Floo/hsArduino/eagle/hsArduino-BOM.xlsx

Sheet: Tabelle1
Anzahl | Part | Value | Package | Sonstiges | Conrad-Best.-Nr. | Conrad-Preis | Reichelt-Best.Nr. | Reichelt-Preis | Segor-Best.-Nr. | Segor-Preis | Mouser-Best.-Nr. | Mouser-Preis | Preis pro Einheit
2 | C8, C9 | 18p | 0805 |  |  |  | NPO-G0805 18P | 0.05 € |  |  |  |  | 0.10 €
2 | C11, C12 | 22p | 0805 |  |  |  | NPO-G0805 22P | 0.05 € |  |  |  |  | 0.10 €
1 | C15 | 1n | 0805 |  |  |  | X7R-G0805 1N | 0.05 € |  |  |  |  | 0.05 €
1 | C16 | 4n7 | 0805 |  |  |  | X7R-G0805 4,7N | 0.05 € |  |  |  |  | 0.05 €
2 | C17, C19 | 6n8 | 0805 |  |  |  | X7R-G0805 6,8N | 0.05 € |  |  |  |  | 0.10 €
2 | C18, C112 | 10n | 0805 |  |  |  | X7R-G0805 10N | 0.05 € |  |  |  |  | 0.10 €
1 | C20 | 22n | 0805 |  |  |  | X7R-G0805 22N | 0.05 € |  |  |  |  | 0.05 €
24 | C7, C12, C14, C21, C22, C23, C24, C100, C101, C102, C103, C104, C105, C106, C107, C108, C109, C110, C111, C114, C115, C116, C117, C118 | 100n | 0805 |  |  |  | X7R-G0805 100N | 0.05 € |  |  |  |  | 1.20 €
1 | C13 | 1µ | 0805 |  |  |  | X7R-G0805 1,0/25 | 0.05 € |  |  |  |  | 0.05 €
1 | C113 | 4µ7 | 0805 |  |  |  | X7R-G0805 4,7/25 | 0.05 € |  |  |  |  | 0.05 €
4 | C2, C4, C5, C6 | 10µ | RM2/5 |  |  |  | RAD 10/35 | 0.04 € |  |  |  |  | 0.16 €
 | C3 | 47µ | RM2/5 |  |  |  | RAD 47/16 | 0.04 € |  |  |  |  | 0.00 €
 | C1 | 100µ | RM2,5/7 |  |  |  | RAD 100/25 | 0.04 € |  |  |  |  | 0.00 €
1 | R18 | 10 | 0805 |  |  |  |  | 0.08 € |  |  |  |  | 0.08 €
2 | R6, R7 | 22 | 0805 |  |  |  |  | 0.08 € |  |  |  |  | 0.16 €
2 | R17, R19 | 50 | 0805 |  |  |  |  | 0.08 € |  |  |  |  | 0.16 €
2 | R28, R31 | 75 | 0805 |  |  |  |  | 0.08 € |  |  |  |  | 0.16 €
2 | R15, R16 | 82 | 0805 |  |  |  |  | 0.08 € |  |  |  |  | 0.16 €
2 | R29, R30 | 150 | 0805 |  |  |  |  | 0.08 € |  |  |  |  | 0.16 €
7 | R13, R14, R25, R26, R27, R32, R33 | 220 | 0805 |  |  |  |  | 0.08 € |  |  |  |  | 0.56 €
9 | R3, R4, R11, R12, R20, R21, R23, R24, R35 | 10k | 0805 |  |  |  |  | 0.08 € |  |  |  |  | 0.72 €
1 | R9 | 12.4k 1% | 0805 |  |  |  |  | 0.08 € |  |  |  |  | 0.08 €
3 | R22, R34, R36 | 15k | 0805 |  |  |  |  | 0.08 € |  |  |  |  | 0.24 €
2 | R1, R10 | 1M | 0805 |  |  |  |  | 0.08 € |  |  |  |  | 0.16 €
1 | R2 | 4816 10k | BOURNS RESISTOR NETWORK |  |  |  |  |  |  |  | 652-4816P-1LF-10K | 0.85 € | 0.85 €
3 | R5, R8, R37 | CG0603-05 | 0603 | Varistor |  |  |  |  |  |  | 652-CG0603MLU-05E | 0.26 € | 0.78 €
1 | L1 | MH2029 | Inductor |  |  |  |  |  |  |  | 652-MH2029-100Y | 0.09 € | 0.09 €
1 | L2 | 1A 120R@100MHz 0.14R | Inductor |  |  |  |  |  |  |  | 652-MH2029-121Y | 0.09 € | 0.09 € | Woher??
1 | IC6 | MAX3232CSE | NarrowSO16 |  |  |  | MAX 3232 CSE | 1.10 € |  |  |  |  | 1.10 €
2 | Q1, Q2 | IRLML6401 | MICRO3 |  |  |  | IRLML6401 | 0.15 € |  |  |  |  | 0.30 €
1 | T2 | H1102NL |  |  |  |  |  |  |  |  | 673-H1102FNL | 4.33 € | 4.33 €
1 | IC2 | TS1117CW-3.3 | SOT223 |  |  |  | TS 1117 BCW33 | 0.30 € |  |  |  |  | 0.30 €
1 | IC1 | R-78B5.0-1.5 |  |  |  |  |  |  |  |  | 919-R-78B5.0-1.0 | 6.96 € | 6.96 € | 1 A??
1 | Q3 | 25MHz HC49 | LowProfile |  |  |  | 25,0000-HC49U-S | 0.17 € |  |  |  |  | 0.17 €
1 | Q4 | 16MHz HC49 | LowProfile |  |  |  | 16,0000-HC49U-S | 0.14 € |  |  |  |  | 0.14 €
2 | T1, T3 | BC859(BC807-40) |  |  |  |  | BC 859C SMD | 0.04 € |  |  |  |  | 0.08 €
2 | D1, D2 | BAS40 | SOT-23 |  |  |  | BAS 40 SMD | 0.07 € |  |  |  |  | 0.14 €
1 | D4 | BAS40-04 | SOT-23 |  |  |  | BAS 40-04 SMD | 0.05 € |  |  |  |  | 0.05 €
1 | U1 | W5500 |  |  |  |  |  |  |  |  | 950-W5500 | 2.69 € | 2.69 €
1 | U2 | ATMEGA32U4-AU |  |  |  |  |  |  |  |  | 556-ATMEGA32U4-AU | 5.13 € | 5.13 €
1 | IC3 | LMV321M5 | SOT23-5 |  |  |  |  |  |  |  | 926-LMV321M5/NOPB | 0.70 € | 0.70 €
2 | IC4, IC5 | 74LVC1G14DBV | SOT23-5 |  |  |  |  |  |  |  | 595-SN74LVC1G14DBVR | 0.41 € | 0.82 €
1 | SV1 | Wanne 6pol |  |  |  |  | WSL6G | 0.16 € |  |  |  |  | 0.16 €
1 | SV4 | Wanne 10pol |  |  |  |  | WSL10G | 0.08 € |  |  |  |  | 0.08 €
1 |  | Phoenix2pol |  |  |  | 0.56 € |  |  |  |  |  |  | 0.56 €
1 |  | Phoenix3pol |  |  |  | 0.85 € |  |  |  |  |  |  | 0.85 €
1 |  | Phoenix12pol |  |  |  | 3.37 € |  |  |  |  |  |  | 3.37 €
1 |  | Phoenix8pol |  |  |  | 2.24 € |  |  |  |  |  |  | 2.24 €
 |  |  |  |  |  |  |  |  |  |  |  |  | 36.63 €

Sheet: E6_main
Part | Value | Device | Package | Description | MF MPN OC_FARNELL OC_NEWARK
C1 | 100µ | CPOL-EUE2.5-7 | E2,5-7 | POLARIZED CAPACITOR, European | symbol
C2 | 10µ | CPOL-EUE2-5 | E2-5 | POLARIZED CAPACITOR, European | symbol
C3 | 47µ | CPOL-EUE2-5 | E2-5 | POLARIZED CAPACITOR, European | symbol
C4 | 10µ | CPOL-EUE2-5 | E2-5 | POLARIZED CAPACITOR, European | symbol
C5 | 10µ | CPOL-EUE2-5 | E2-5 | POLARIZED CAPACITOR, European | symbol
C6 | 10µ | CPOL-EUE2-5 | E2-5 | POLARIZED CAPACITOR, European | symbol
C7 | 100n | C-EUC0805K | C0805K | CAPACITOR, European symbol
C8 | 18p | C-EUC0805K | C0805K | CAPACITOR, European symbol
C9 | 18p | C-EUC0805K | C0805K | CAPACITOR, European symbol
C10 | 22p | C-EUC0805K | C0805K | CAPACITOR, European symbol
C11 | 22p | C-EUC0805K | C0805K | CAPACITOR, European symbol
C12 | 100n | C-EUC0805K | C0805K | CAPACITOR, European symbol
C13 | 1µ | C-EUC0805K | C0805K | CAPACITOR, European symbol
C14 | 100n | C-EUC0805K | C0805K | CAPACITOR, European symbol
C15 | 1n | C-EUC0805K | C0805K | CAPACITOR, European symbol
C16 | 4n7 | C-EUC0805K | C0805K | CAPACITOR, European symbol
C17 | 6n8 | C-EUC0805K | C0805K | CAPACITOR, European symbol
C18 | 10n | C-EUC0805K | C0805K | CAPACITOR, European symbol
C19 | 6n8 | C-EUC0805K | C0805K | CAPACITOR, European symbol
C20 | 22n | C-EUC0805K | C0805K | CAPACITOR, European symbol
C21 | 100n | C-EUC0805K | C0805K | CAPACITOR, European symbol
C22 | 100n | C-EUC0805K | C0805K | CAPACITOR, European symbol
C23 | 100n | C-EUC0805K | C0805K | CAPACITOR, European symbol
C24 | 100n | C-EUC0805K | C0805K | CAPACITOR, European symbol
C100 | 100n | C-EUC0805K | C0805K | CAPACITOR, European symbol
C101 | 100n | C-EUC0805K | C0805K | CAPACITOR, European symbol
C102 | 100n | C-EUC0805K | C0805K | CAPACITOR, European symbol
C103 | 100n | C-EUC0805K | C0805K | CAPACITOR, European symbol
C104 | 100n | C-EUC0805K | C0805K | CAPACITOR, European symbol
C105 | 100n | C-EUC0805K | C0805K | CAPACITOR, European symbol
C106 | 100n | C-EUC0805K | C0805K | CAPACITOR, European symbol
C107 | 100n | C-EUC0805K | C0805K | CAPACITOR, European symbol
C108 | 100n | C-EUC0805K | C0805K | CAPACITOR, European symbol
C109 | 100n | C-EUC0805K | C0805K | CAPACITOR, European symbol
C110 | 100n | C-EUC0805K | C0805K | CAPACITOR, European symbol
C111 | 100n | C-EUC0805K | C0805K | CAPACITOR, European symbol
C112 | 10n | C-EUC0805K | C0805K | CAPACITOR, European symbol
C113 | 4µ7 | C-EUC0805K | C0805K | CAPACITOR, European symbol
C114 | 100n | C-EUC0805K | C0805K | CAPACITOR, European symbol
C115 | 100n | C-EUC0805K | C0805K | CAPACITOR, European symbol
C116 | 100n | C-EUC0805K | C0805K | CAPACITOR, European symbol
C117 | 100n | C-EUC0805K | C0805K | CAPACITOR, European symbol
C118 | 100n | C-EUC0805K | C0805K | CAPACITOR, European symbol
D1 | BAS40 | BAS40 | SOT23 | Silicon Schottky Diodes
D2 | BAS40 | BAS40 | SOT23 | Silicon Schottky Diodes
D3 |  | DIODE-SOT54H | SOT54H | DIODE
D4 | BAS40-04 | BAS40-04 | SOT23 | Silicon Schottky Diodes
IC1 | R-78B5.0-1.5 | 7805TV | TO220V | Positive VOLTAGE REGULATOR
IC2 | REG1117 | REG1117 | SOT223 | 800mA and 1A Low Dropout (LDO | ) Positive Regulator
IC3 | LMV321M5 | LMV321M5 | SOT23-5 | General Purpose, Low Voltage, | Rail-to-Rail Output Operational Amplifiers
IC4 | 74LVC1G14DBV | 74LVC1G14DBV | SOT23-5 | Single Schmitt-Trigger Invert | er Gate
IC5 | 74LVC1G14DBV | 74LVC1G14DBV | SOT23-5 | Single Schmitt-Trigger Invert | er Gate
IC6 | MAX3232CSE | MAX3232CSE | SO16 | True RS-232 Transceivers 3.0V | to 5.5V, Low-Power
JMP1 |  | 0R-JUMPA | A0R-JMP | SMD 0R 0805 Jumper
JMP2 |  | 0R-JUMPA | A0R-JMP | SMD 0R 0805 Jumper
L1 | MH2029 | SM-1206 | SM-1206 | INDUCTOR | unknown unknown
L2 | 1A 120R@100MHz 0.14R | SM-1206 | SM-1206 | INDUCTOR | unknown unknown
Q1 | IRLML6401 | IRLML5203 | MICRO3 | HEXFET P-Channel Power MOSFET
Q2 | IRLML6401 | IRLML5203 | MICRO3 | HEXFET P-Channel Power MOSFET
Q3 | 25MHz | CRYSTALHC49S | HC49/S | CRYSTAL
Q4 | 16MHz | CRYSTALHC49S | HC49/S | CRYSTAL
R1 | 680k | R-EU_R0805 | R0805 | RESISTOR, European symbol
R2 | 4816 10k | 4816P-T01 | 4816P | BOURNS RESISTOR NETWORK | BOURNS, INC. 4816P-T01-684LF 9357483 33K0707
R3 | 10k | R-EU_R0805 | R0805 | RESISTOR, European symbol
R4 | 10k | R-EU_R0805 | R0805 | RESISTOR, European symbol
R5 | CG0603-05 | VARISTORCN0603 | CT/CN0603 | VARISTOR
R6 | 22 | R-EU_R0805 | R0805 | RESISTOR, European symbol
R7 | 22 | R-EU_R0805 | R0805 | RESISTOR, European symbol
R8 | CG0603-05 | VARISTORCN0603 | CT/CN0603 | VARISTOR
R9 | 12.4k 1% | R-EU_R0805 | R0805 | RESISTOR, European symbol
R10 | 1M | R-EU_R0805 | R0805 | RESISTOR, European symbol
R11 | 10k | R-EU_R0805 | R0805 | RESISTOR, European symbol
R12 | 10k | R-EU_R0805 | R0805 | RESISTOR, European symbol
R13 | 220 | R-EU_R0805 | R0805 | RESISTOR, European symbol
R14 | 220 | R-EU_R0805 | R0805 | RESISTOR, European symbol
R15 | 82 | R-EU_R0805 | R0805 | RESISTOR, European symbol
R16 | 82 | R-EU_R0805 | R0805 | RESISTOR, European symbol
R17 | 50 | R-EU_R0805 | R0805 | RESISTOR, European symbol
R18 | 10 | R-EU_R0805 | R0805 | RESISTOR, European symbol
R19 | 50 | R-EU_R0805 | R0805 | RESISTOR, European symbol
R20 | 10k | R-EU_R0805 | R0805 | RESISTOR, European symbol
R21 | 10k | R-EU_R0805 | R0805 | RESISTOR, European symbol
R22 | 22k | R-EU_R0805 | R0805 | RESISTOR, European symbol
R23 | 10k | R-EU_R0805 | R0805 | RESISTOR, European symbol
R24 | 10k | R-EU_R0805 | R0805 | RESISTOR, European symbol
R25 | 220 | R-EU_R0805 | R0805 | RESISTOR, European symbol
R26 | 220 | R-EU_R0805 | R0805 | RESISTOR, European symbol
R27 | 220 | R-EU_R0805 | R0805 | RESISTOR, European symbol
R28 | 75 | R-EU_R0805 | R0805 | RESISTOR, European symbol
R29 | 150 | R-EU_R0805 | R0805 | RESISTOR, European symbol
R30 | 150 | R-EU_R0805 | R0805 | RESISTOR, European symbol
R31 | 75 | R-EU_R0805 | R0805 | RESISTOR, European symbol
R32 | 220 | R-EU_R0805 | R0805 | RESISTOR, European symbol
R33 | 220 | R-EU_R0805 | R0805 | RESISTOR, European symbol
R34 | 22k | R-EU_R0805 | R0805 | RESISTOR, European symbol
R35 | 10k | R-EU_R0805 | R0805 | RESISTOR, European symbol
R36 | 15k | R-EU_R0805 | R0805 | RESISTOR, European symbol
SV1 |  | ML6 | ML6 | HARTING
SV2 |  | MA04-1 | MA04-1 | PIN HEADER | unknown unknown
SV3 | FS20_REC | MA06-1 | MA06-1 | PIN HEADER
SV4 |  | ML10 | ML10 | HARTING
SV5 | FS20_SEND | MA03-1 | MA03-1 | PIN HEADER
T1 | BC859 | BC857A-PNP-SOT23-BEC | SOT23-BEC | PNP Transistror
T2 | H1102NL | HX1188 | HXXXX | Transformer- H110X, H1121, HX | 1188
T3 | BC859 | BC857A-PNP-SOT23-BEC | SOT23-BEC | PNP Transistror
U1 | W5500 | W5500 | W5500
U2 | ATMEGA32U4-AU | ATMEGA32U4-AU | TQFP44 | ATMega32U4-AU
X1 |  | W237-02P | W237-132 | WAGO SREW CLAMP
X2 | MINI-USB-32005-201 | MINI-USB-32005-201 | 32005-201 | MINI USB-B Conector | unknown unknown
X3 |  | W237-02P | W237-132 | WAGO SREW CLAMP
X4 |  | W237-02P | W237-132 | WAGO SREW CLAMP
X5 |  | W237-02P | W237-132 | WAGO SREW CLAMP
X6 |  | W237-02P | W237-132 | WAGO SREW CLAMP
X7 |  | W237-02P | W237-132 | WAGO SREW CLAMP
X8 |  | W237-02P | W237-132 | WAGO SREW CLAMP
X9 |  | W237-02P | W237-132 | WAGO SREW CLAMP
X10 |  | W237-05P | W237-5P | WAGO SREW CLAMP
X11 |  | W237-02P | W237-132 | WAGO SREW CLAMP
X12 |  | W237-02P | W237-132 | WAGO SREW CLAMP
