Floo/hsArduino/eagle/hsArduino_schematics.pdf

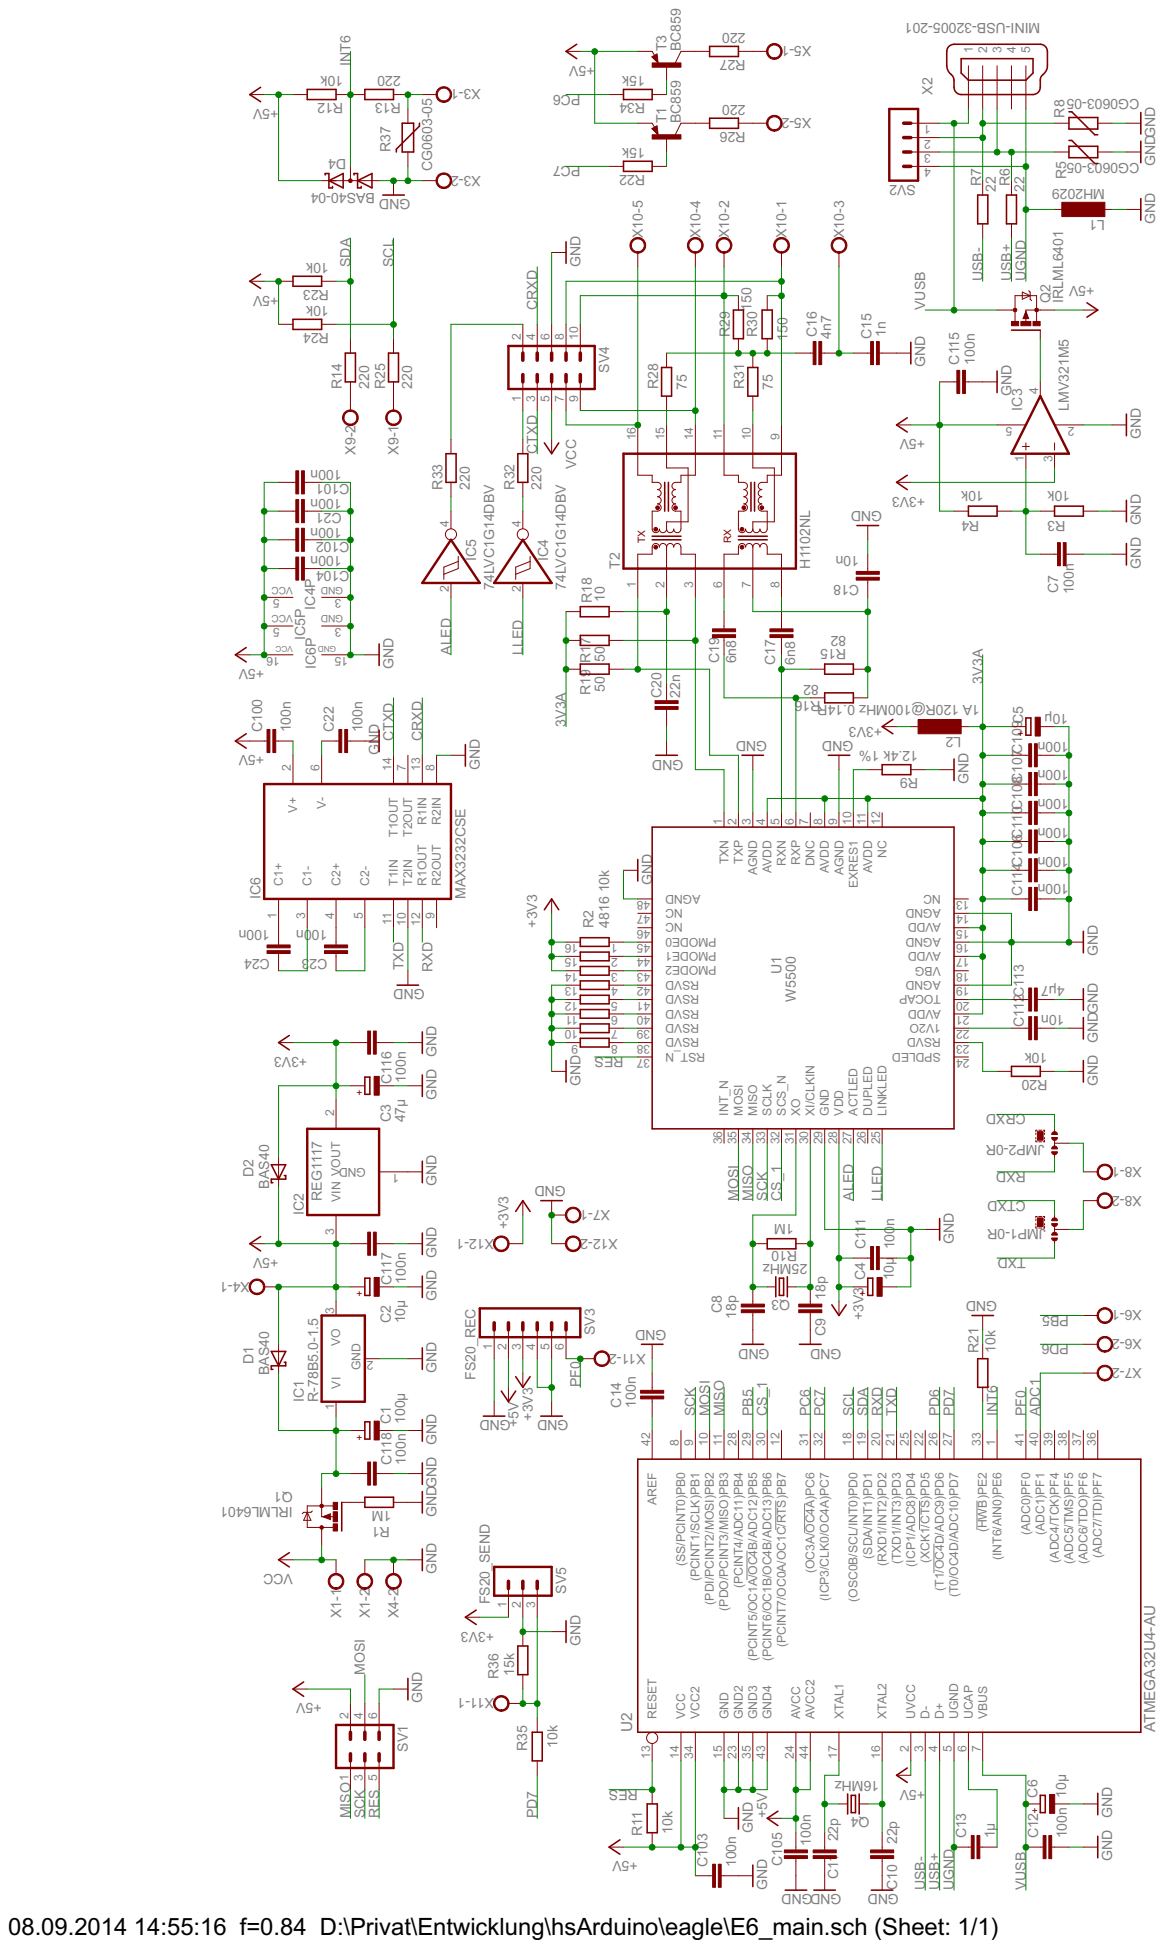
[picture p1: page 1]

USB- USB- USB+ USB+

47µ 10µ 100n 100n GND GND GND GND

08.09.2014 14:55:16 f=0.84 D:\Privat\Entwicklung\hsArduino\eagle\E6_main.sch (Sheet: 1/1)
