Floo/hsArduino/eagle/hsArduino_bottom.pdf

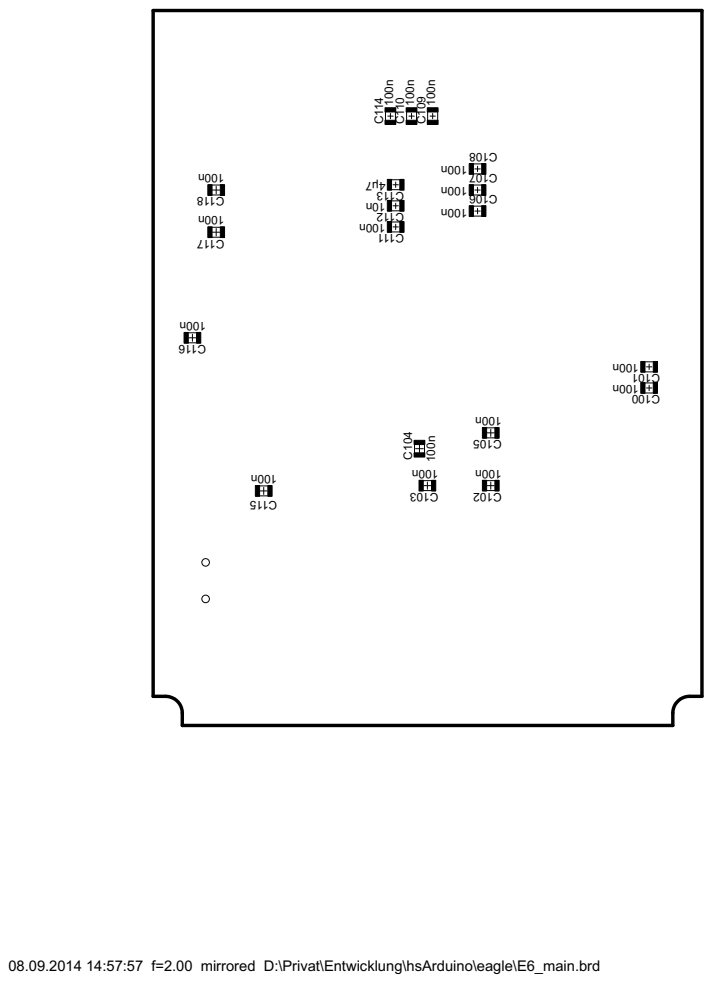
[picture p2: page 1]

08.09.2014 14:57:57 f=2.00 mirrored D:\Privat\Entwicklung\hsArduino\eagle\E6_main.brd
