Floo/hsArduino/eagle/hsArduino_top.pdf

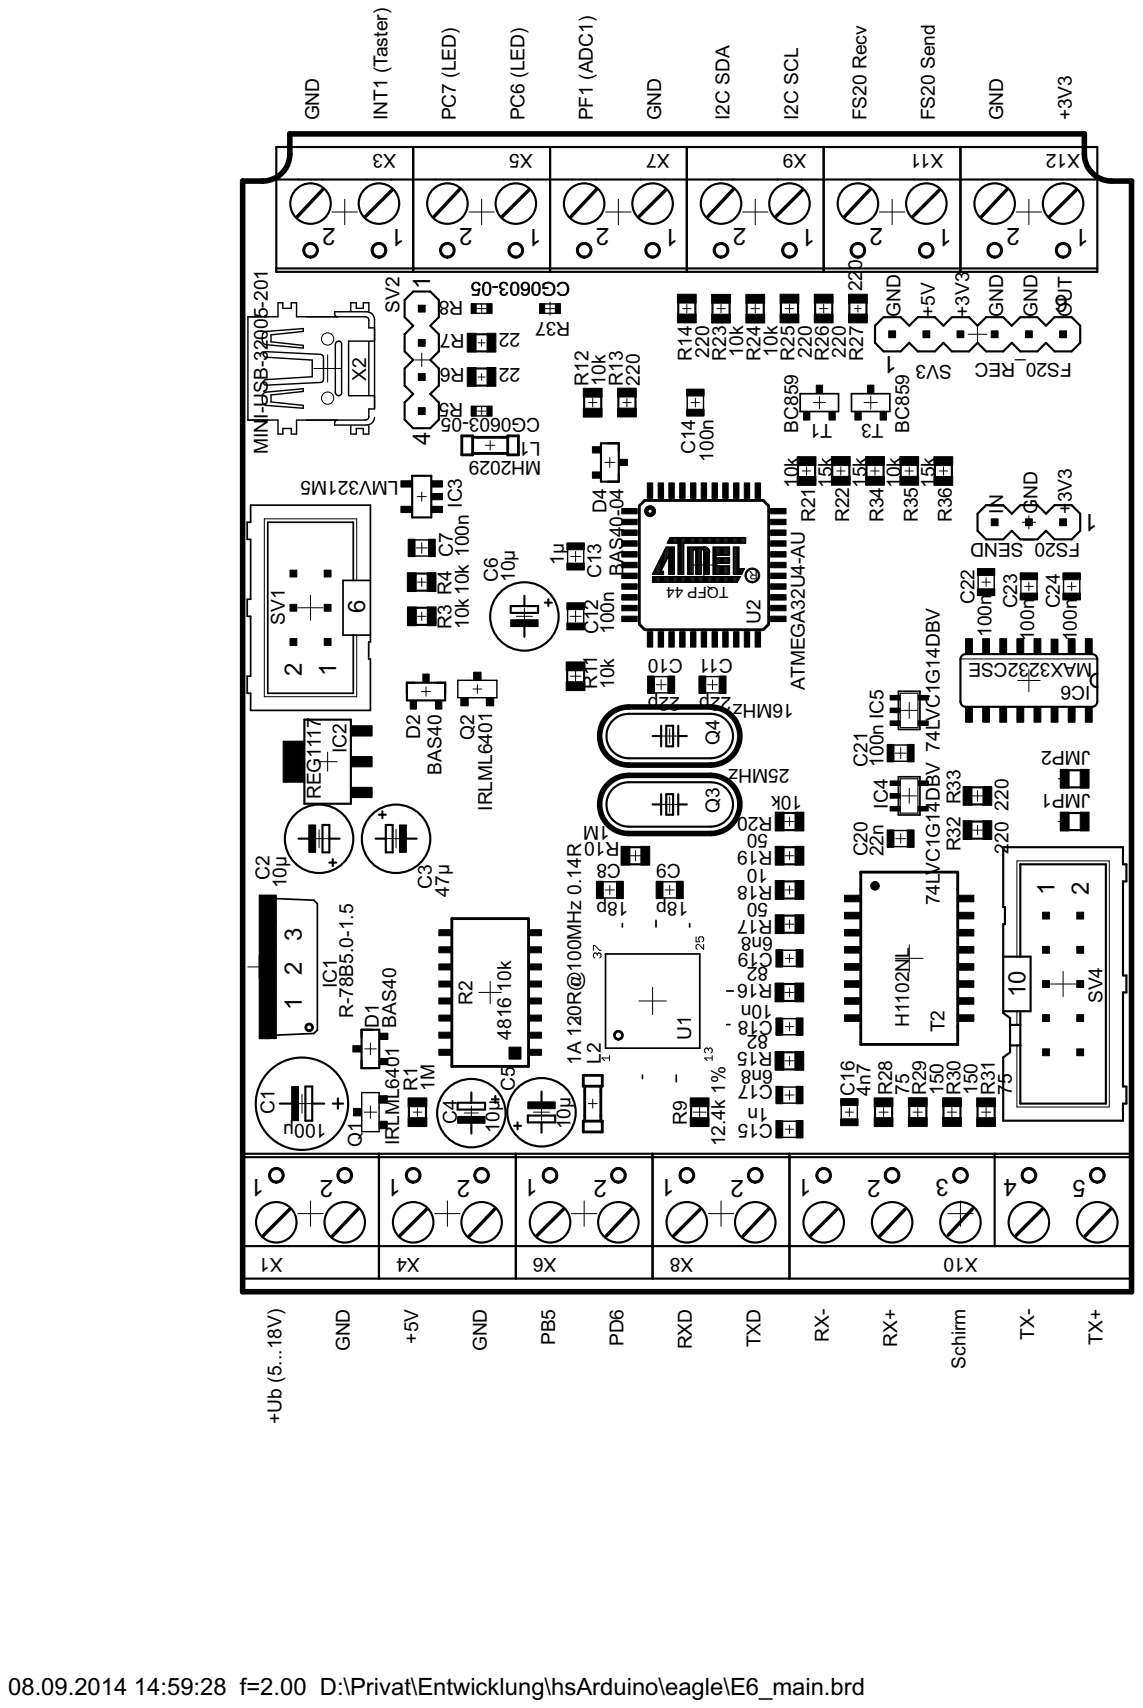
[picture p3: page 1]

08.09.2014 14:59:28 f=2.00 D:\Privat\Entwicklung\hsArduino\eagle\E6_main.brd
