Floo/hsArduino/eagle/hsArduino.brd

## EAGLE design eagle/hsArduino.brd (2014-09-08)

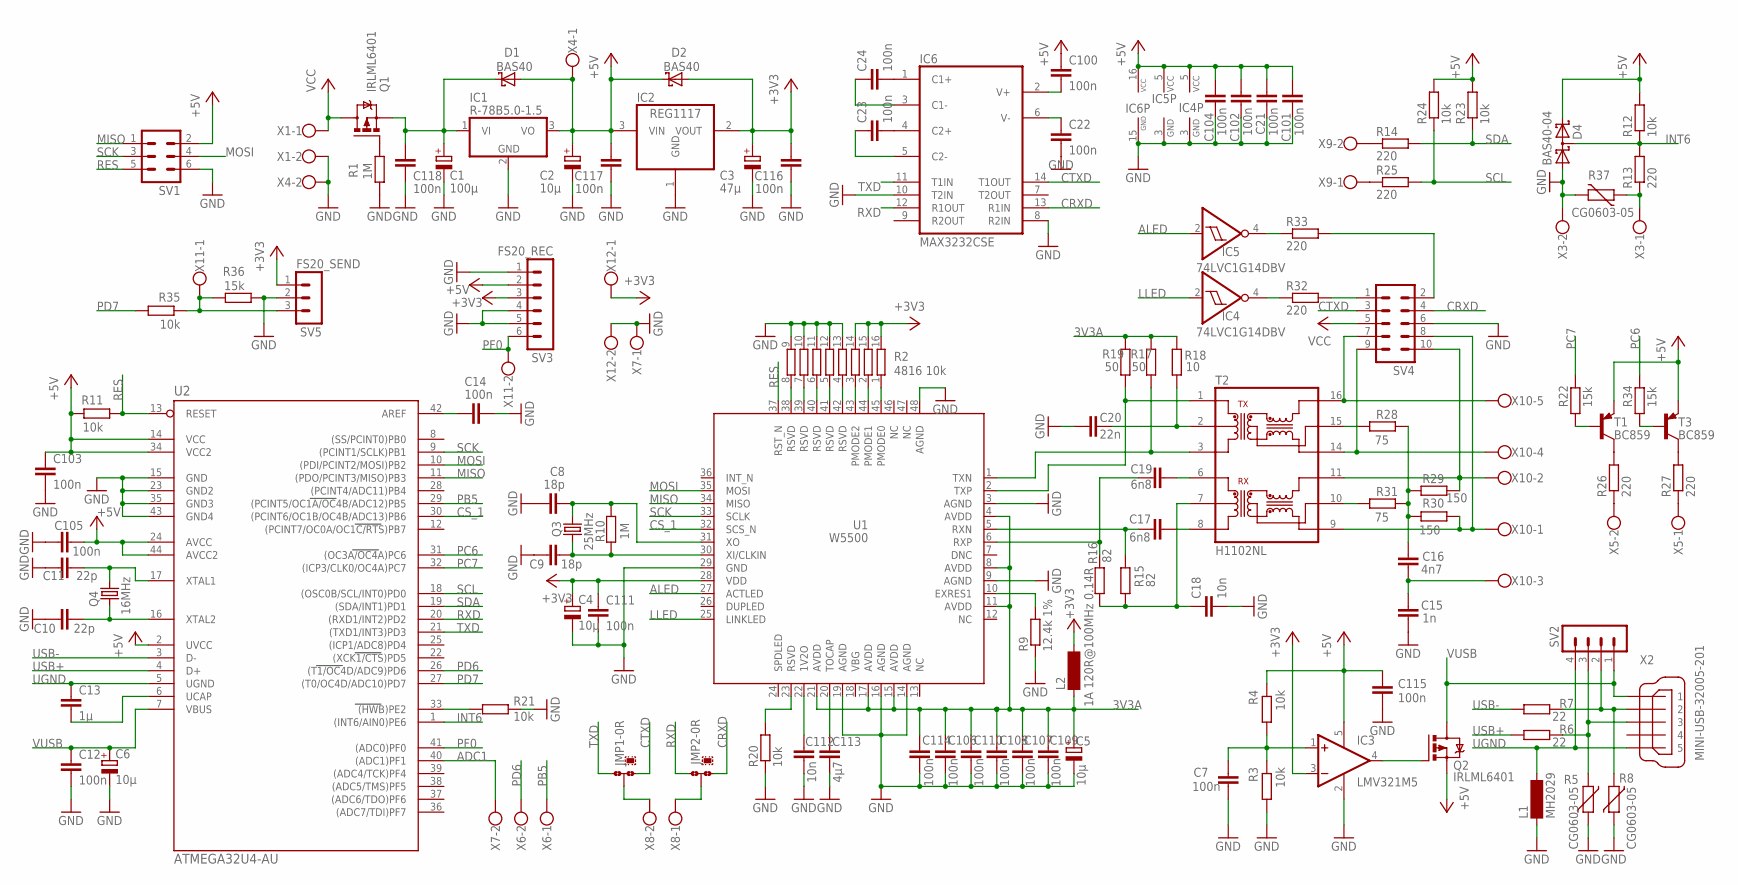
[picture p4: schematic hsArduino.sch]

Parts:
C1: 100µ; E2,5-7
C2, C4, C5, C6: 10µ; E2-5
C3: 47µ; E2-5
C7, C12, C14, C21, C22, C23, C24, C100, C101, C102, C103, C104, C105, C106, C107, C108, C109, C110, C111, C114, C115, C116, C117, C118: 100n; C0805K
C8, C9: 18p; C0805K
C10, C11: 22p; C0805K
C13: 1µ; C0805K
C15: 1n; C0805K
C16: 4n7; C0805K
C17, C19: 6n8; C0805K
C18, C112: 10n; C0805K
C20: 22n; C0805K
C113: 4µ7; C0805K
D1, D2: BAS40; SOT23
D4: BAS40-04; SOT23
IC1: R-78B5.0-1.5; TO220V
IC2: REG1117; SOT223
IC3: LMV321M5; SOT23-5
IC4, IC5: 74LVC1G14DBV; SOT23-5
IC6: MAX3232CSE; SO16
JMP1, JMP2: 0R-JUMPA; A0R-JMP
L1: MH2029; SM-1206
L2: 1A 120R@100MHz 0.14R; SM-1206
Q1, Q2: IRLML6401; MICRO3
Q3: 25MHz; HC49/S
Q4: 16MHz; HC49/S
R1, R10: 1M; R0805
R2: 4816 10k; 4816P
R3, R4, R11, R12, R20, R21, R23, R24, R35: 10k; R0805
R5, R8, R37: CG0603-05; CT/CN0603
R6, R7: 22; R0805
R9: 12.4k 1%; R0805
R13, R14, R25, R26, R27, R32, R33: 220; R0805
R15, R16: 82; R0805
R17, R19: 50; R0805
R18: 10; R0805
R22, R34, R36: 15k; R0805
R28, R31: 75; R0805
R29, R30: 150; R0805
SV1: ML6
SV2: MA04-1
SV3: FS20_REC; MA06-1
SV4: ML10
SV5: FS20_SEND; MA03-1
T1, T3: BC859; SOT23-BEC
T2: H1102NL; HXXXX
U1: W5500
U2: ATMEGA32U4-AU; TQFP44
X1, X3, X4, X5, X6, X7, X8, X9, X11, X12: W237-02P; W237-132
X2: MINI-USB-32005-201; 32005-201
X10: W237-05P; W237-5P

Connections:
3V3A: C5.+, C106.1, C107.1, C108.1, C109.1, C110.1, C114.1, L2.1, R17.2, R18.2, R19.2, U1.4 (AVDD), U1.8 (AVDD), U1.11 (AVDD), U1.15 (AVDD), U1.17 (AVDD), U1.21 (AVDD)
+3V3: C3.+, C4.+, C111.1, C116.2, D2.1 (A), IC2.2 (VOUT), IC3.3 (-IN), L2.2, R2.14, R2.15, R2.16, SV3.3, SV5.1, U1.28 (VDD), X12.1
+5V: C2.+, C21.1, C100.1, C101.1, C102.2, C103.1, C104.2, C105.1, C115.2, C117.2, D1.1 (A), D2.3 (C), D4.2 (C2), IC1.3 (VO), IC2.3 (VIN), IC3.5 (V+), IC4.5 (VCC), IC5.5 (VCC), IC6.16 (VCC), Q2.2 (S), R4.1, R11.2, R12.2, R23.2, R24.2, SV1.2, SV3.2, T1.E, T3.E, U2.2 (UVCC), U2.14 (VCC), U2.24 (AVCC), U2.34 (VCC2), U2.44 (AVCC2), X4.1
ADC1: U2.40 ((ADC1)PF1), X7.2
ALED: IC5.2 (I), U1.27 (ACTLED)
CRXD: IC6.13 (R1IN), JMP2.1, SV4.4
CS_1: U1.32 (SCS_N), U2.30 ((PCINT6/OC1B/OC4B/ADC13)PB6)
CTXD: IC6.14 (T1OUT), JMP1.1, SV4.3
GND: C1.-, C2.-, C3.-, C4.-, C5.-, C6.-, C7.2, C8.1, C9.2, C10.2, C11.1, C12.2, C14.2, C15.1, C18.2, C20.1, C21.2, C22.2, C101.2, C102.1, C103.2, C104.1, C105.2, C106.2, C107.2, C108.2, C109.2, C110.2, C111.2, C112.2, C113.2, C114.2, C115.1, C116.1, C117.1, C118.2, D4.1 (A1), IC1.2 (GND), IC2.1 (GND), IC3.2 (V-), IC4.3 (GND), IC5.3 (GND), IC6.8 (R2IN), IC6.10 (T2IN), IC6.15 (GND), L1.1, R1.2, R2.9, R2.10, R2.11, R2.12, R2.13, R3.2, R5.2, R8.2, R9.1, R20.1, R21.2, R36.1, R37.2, SV1.6, SV3.1, SV3.4, SV3.5, SV4.6, SV5.2, U1.3 (AGND), U1.9 (AGND), U1.14 (AGND), U1.16 (AGND), U1.19 (AGND), U1.29 (GND), U1.48 (AGND), U2.15 (GND), U2.23 (GND2), U2.35 (GND3), U2.43 (GND4), X1.2, X3.2, X4.2, X7.1, X12.2
INT6: D4.3 (C1A2), R12.1, R13.2, U2.1 ((INT6/AIN0)PE6)
LLED: IC4.2 (I), U1.25 (LINKLED)
MISO: SV1.1, U1.34 (MISO), U2.11 ((PDO/PCINT3/MISO)PB3)
MOSI: SV1.4, U1.35 (MOSI), U2.10 ((PDI/PCINT2/MOSI)PB2)
unnamed: C10.1, Q4.2, U2.16 (XTAL2)
unnamed: C11.2, Q4.1, U2.17 (XTAL1)
unnamed: C17.1, R15.1, U1.5 (RXN)
unnamed: C1.+, C118.1, D1.3 (C), IC1.1 (VI), Q1.2 (S)
unnamed: C113.1, U1.20 (TOCAP)
unnamed: C19.1, R16.1, U1.6 (RXP)
unnamed: C9.1, Q3.2, R10.2, U1.30 (XI/CLKIN)
unnamed: R35.1, R36.2, SV5.3, X11.1
unnamed: JMP1.2, X8.2
unnamed: C20.2, R18.1, T2.2
unnamed: Q1.1 (G), R1.1
unnamed: C8.2, Q3.1, R10.1, U1.31 (XO)
unnamed: R19.1, T2.1, U1.2 (TXP)
unnamed: R2.8, U1.38 (RSVD)
unnamed: R20.2, U1.23 (RSVD)
unnamed: C18.1, R15.2, R16.2, T2.7
unnamed: R17.1, T2.3, U1.1 (TXN)
unnamed: C19.2, T2.6
unnamed: SV4.7, T2.16, X10.5
unnamed: C112.1, U1.22 (1V2O)
unnamed: SV4.9, T2.14, X10.4
unnamed: R29.1, SV4.10, T2.11, X10.2
unnamed: R28.2, T2.15
unnamed: C15.2, C16.1, X10.3
unnamed: R2.7, U1.39 (RSVD)
unnamed: JMP2.2, X8.1
unnamed: R33.2, SV4.2
unnamed: R9.2, U1.10 (EXRES1)
unnamed: C14.1, U2.42 (AREF)
unnamed: R2.6, U1.40 (RSVD)
unnamed: R2.5, U1.41 (RSVD)
unnamed: R2.4, U1.42 (RSVD)
unnamed: C17.2, T2.8
unnamed: R2.3, U1.43 (PMODE2)
unnamed: R2.2, U1.44 (PMODE1)
unnamed: R2.1, U1.45 (PMODE0)
unnamed: C16.2, R28.1, R29.2, R30.2, R31.1
unnamed: R13.1, R37.1, X3.1
unnamed: R31.2, T2.10
unnamed: R30.1, SV4.8, T2.9, X10.1
unnamed: IC5.4 (O), R33.1
unnamed: IC4.4 (O), R32.1
unnamed: R21.1, U2.33 ((HWB)PE2)
unnamed: R26.1, X5.2
unnamed: R32.2, SV4.1
unnamed: R27.1, X5.1
unnamed: C24.1, IC6.3 (C1-)
unnamed: R7.1, R8.1, SV2.2, X2.2
unnamed: C24.2, IC6.1 (C1+)
unnamed: C23.2, IC6.4 (C2+)
unnamed: C23.1, IC6.5 (C2-)
unnamed: C22.1, IC6.6 (V-)
unnamed: C100.2, IC6.2 (V+)
unnamed: R26.2, T1.C
unnamed: R5.1, R6.1, SV2.3, X2.3
unnamed: R27.2, T3.C
unnamed: R22.1, T1.B
unnamed: R34.1, T3.B
unnamed: C13.2, U2.6 (UCAP)
unnamed: C7.1, IC3.1 (+IN), R3.1, R4.2
unnamed: IC3.4 (OUT), Q2.1 (G)
unnamed: R14.1, X9.2
unnamed: R25.1, X9.1
PB5: U2.29 ((PCINT5/OC1A/OC4B/ADC12)PB5), X6.1
PC6: R34.2, U2.31 ((OC3A/OC4A)PC6)
PC7: R22.2, U2.32 ((ICP3/CLK0/OC4A)PC7)
PD6: U2.26 ((T1/OC4D/ADC9)PD6), X6.2
PD7: R35.2, U2.27 ((T0/OC4D/ADC10)PD7)
PF0: SV3.6, U2.41 ((ADC0)PF0), X11.2
RES: R11.1, SV1.5, U1.37 (RST_N), U2.13 (RESET)
RXD: IC6.12 (R1OUT), JMP2.3, U2.20 ((RXD1/INT2)PD2)
SCK: SV1.3, U1.33 (SCLK), U2.9 ((PCINT1/SCLK)PB1)
SCL: R24.1, R25.2, U2.18 ((OSC0B/SCL/INT0)PD0)
SDA: R14.2, R23.1, U2.19 ((SDA/INT1)PD1)
TXD: IC6.11 (T1IN), JMP1.3, U2.21 ((TXD1/INT3)PD3)
UGND: C13.1, L1.2, SV2.4, U2.5 (UGND), X2.5
USB+: R6.2, U2.4 (D+)
USB-: R7.2, U2.3 (D-)
VCC: Q1.3 (D), SV4.5, X1.1
VUSB: C6.+, C12.1, Q2.3 (D), SV2.1, U2.7 (VBUS), X2.1

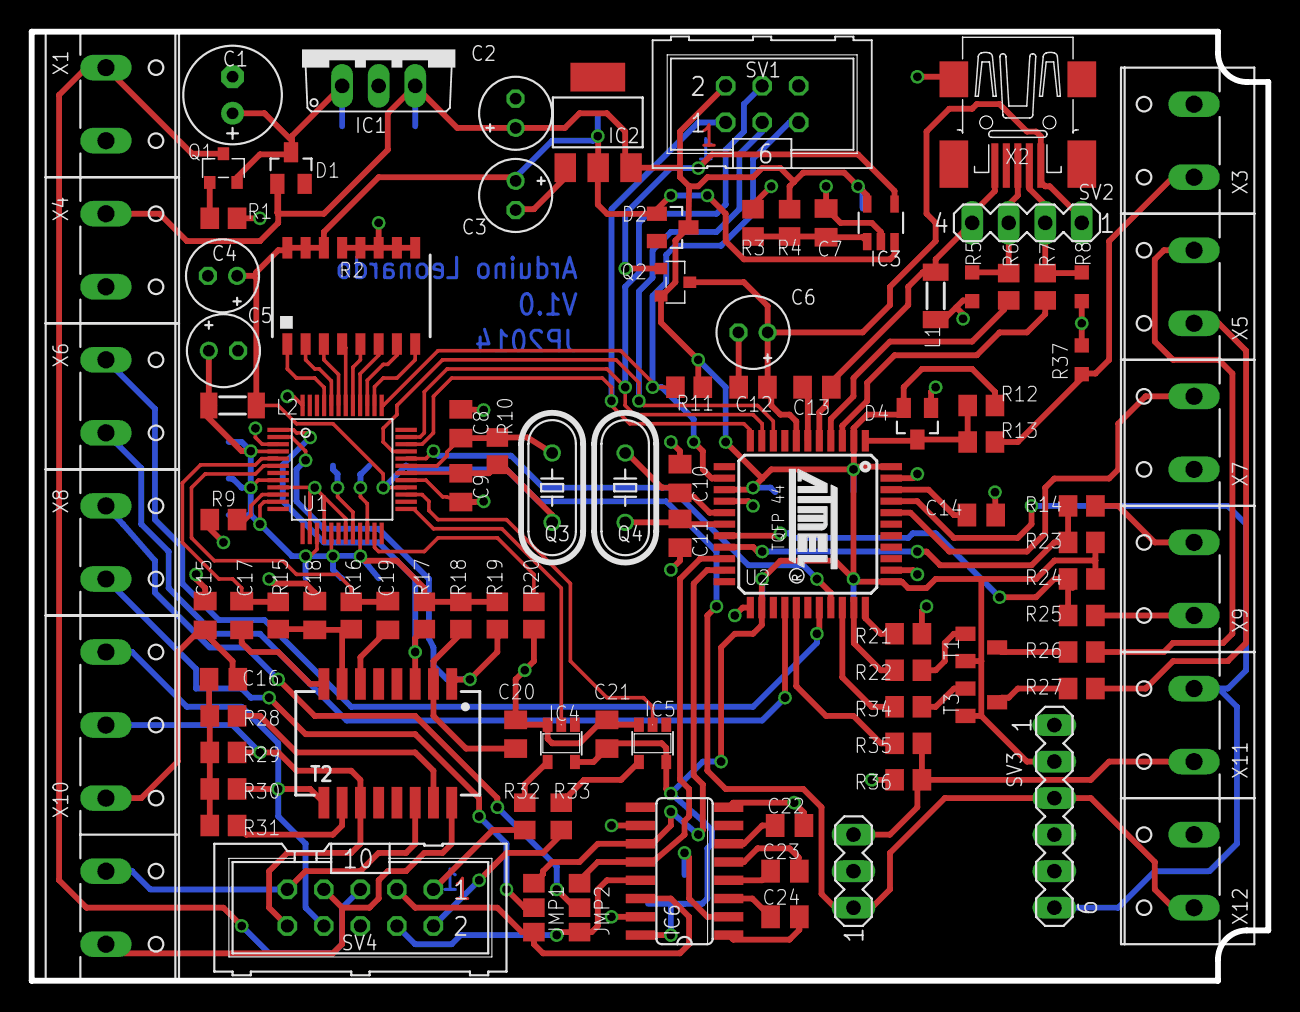
[picture p5: board hsArduino.brd from above]

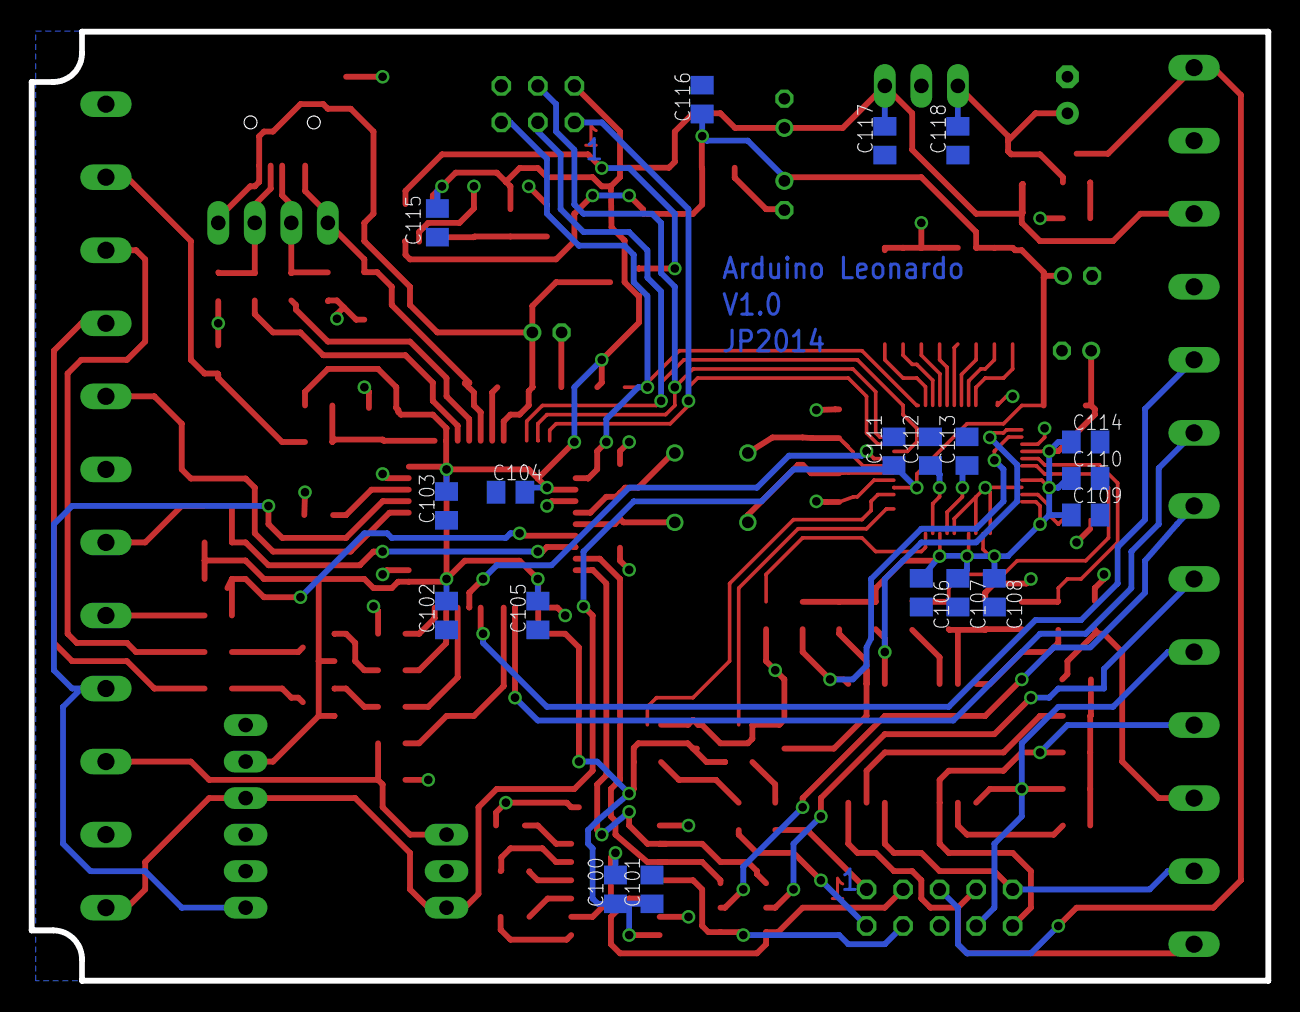
[picture p6: board hsArduino.brd from below]

Board: 2 copper layers, 86.0 x 66.0 mm, 119 parts (19 on the bottom side), 93 nets.
