Floo/hsArduino/(notices)

Notices in the files:
rec868.h:
modify it under the terms of the GNU General Public License
fs20.cpp:
under the terms of the GNU General Public License (either version 2 or
version 3) as published by the Free Software Foundation.
